Alexeyslav/RGBU_light/MASTER/Schematic/shematic.jpg

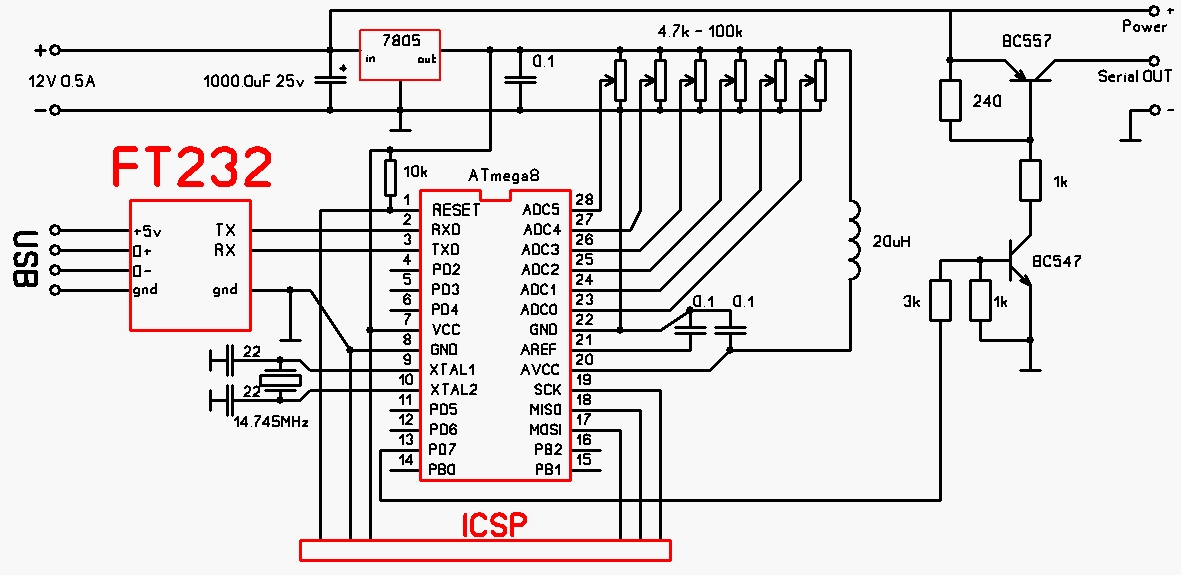
MASTER/Schematic/shematic.jpg
