Alexeyslav/RGBU_light/SLAVE/Calculations/Timing.JPG

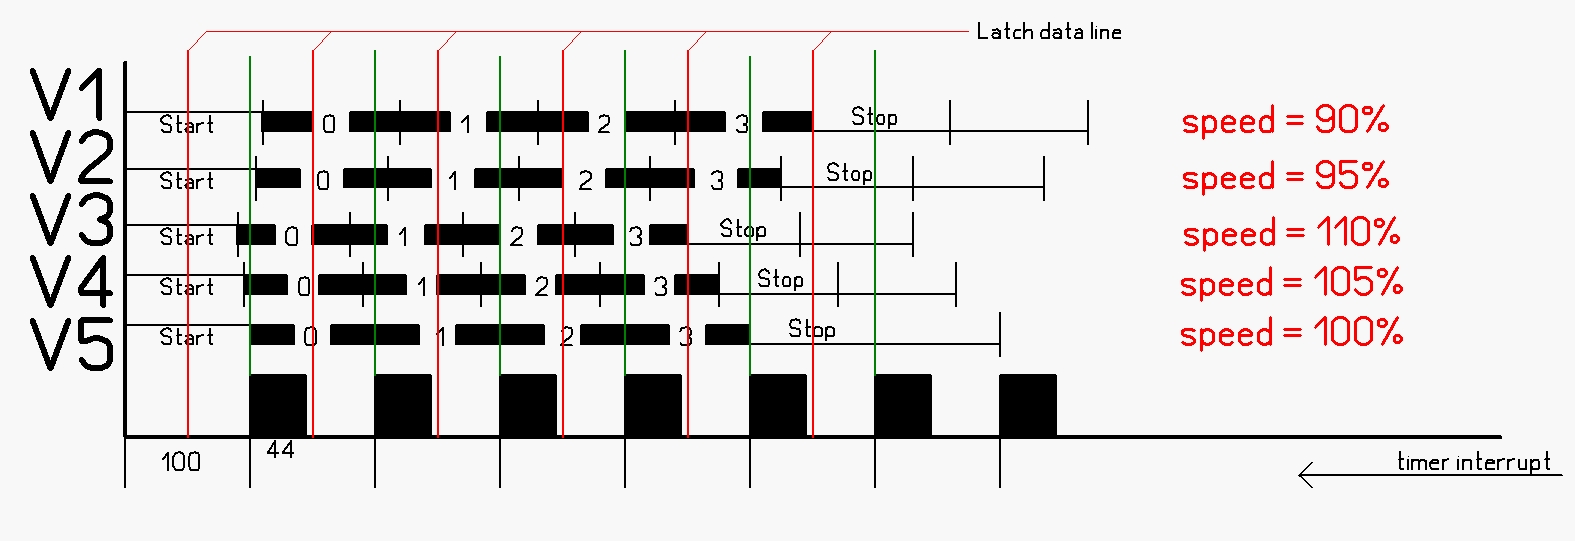
SLAVE/Calculations/Timing.JPG
