Alexeyslav/RGBU_light/SLAVE/Schematic/one_unit_data_pack.jpg

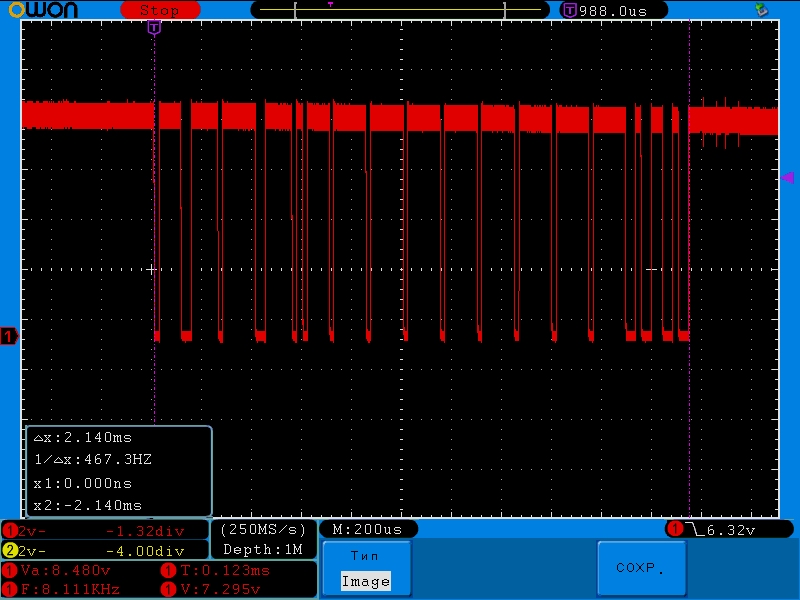
SLAVE/Schematic/one_unit_data_pack.jpg
