Alexeyslav/RGBU_light/SLAVE/Schematic/slave_module_schematic.JPG

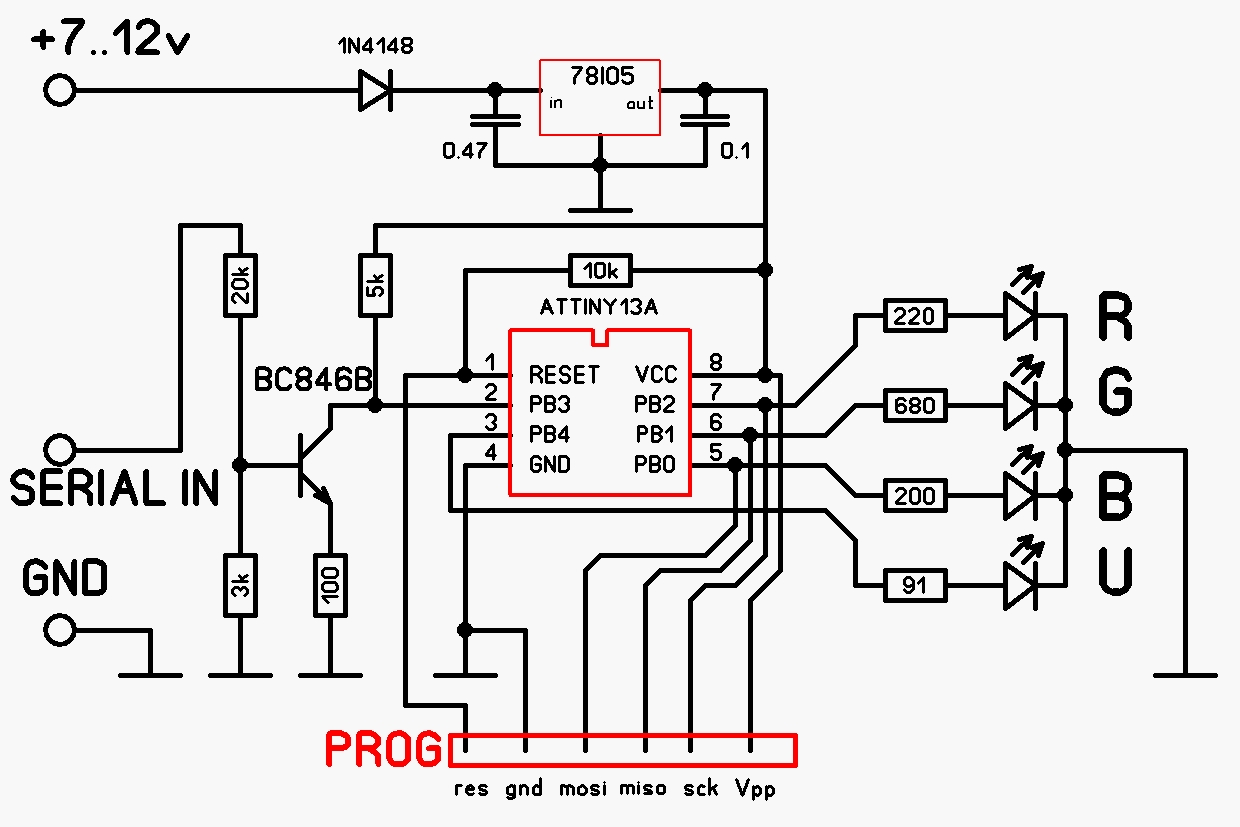
SLAVE/Schematic/slave_module_schematic.JPG
