Alexeyslav/RGBU_light/SLAVE/Schematic/start_osd_rus.jpg

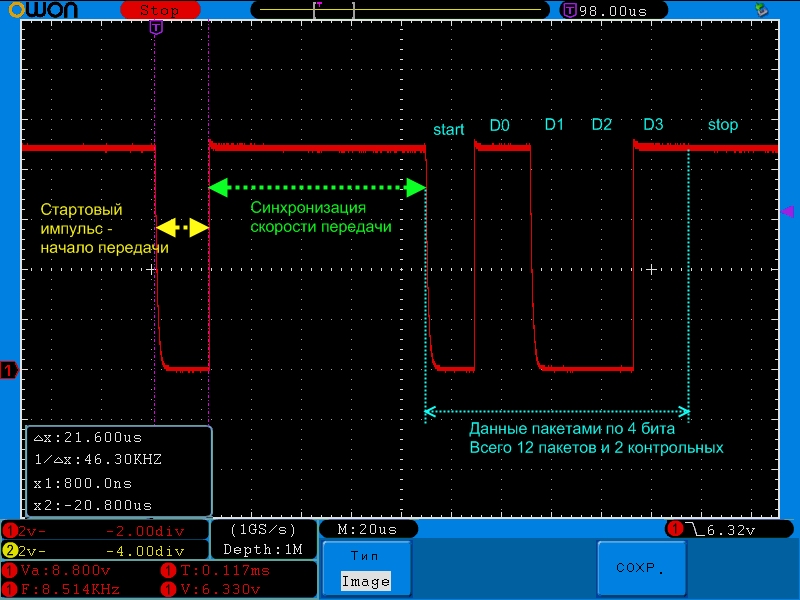
SLAVE/Schematic/start_osd_rus.jpg
