Alexeyslav/RGBU_light/main_shematic.pdf

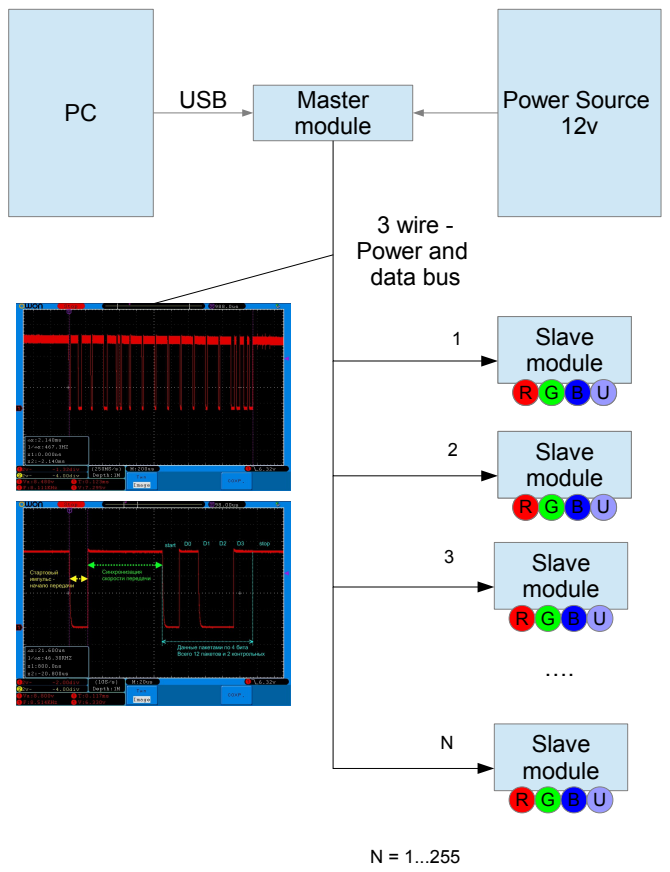
[picture p6: page 1]
Slave module; Master; module; Power Source 12v; USB; 3 wire - Power and data bus; Slave
