Alexeyslav/RGBU_light/MASTER/Calculations/RGBU-MASTER_OUTP.CIR

[Main]
FileType=CIR
Version=7.00
Program=Micro-Cap
Screen=1680,1050
MCAPVersion=7.0.0.0
Key ID=12 345 678
NLCnt=39
TXCnt=1

[shapedef]
Name=Battery
Line=0,0,22,0
Line=22,-3,22,3
Line=26,-7,26,7
Line=26,0,48,0
Current=32,8,16,8

[shapedef]
Name=Pulse_Source
Root="Vsource.root",0,-12,0
Line=20,-4,20,0
Line=20,0,26,0
Line=26,0,26,4

[shapedef]
Name=Resistor
PolyOpen=12 
PolyLine=0,0
PolyLine=0,0
PolyLine=12,0
PolyLine=14,-4
PolyLine=18,4
PolyLine=22,-4
PolyLine=26,4
PolyLine=30,-4
PolyLine=34,4
PolyLine=36,0
PolyLine=48,0
PolyLine=48,0
Current=32,8,16,8

[shapedef]
Name=Capacitor
Line=0,0,22,0
Line=22,-8,22,8
Line=26,-8,26,8
Line=26,0,48,0
Current=32,12,16,12

[shapedef]
Name=NPN
Root="Bjt.root",0,-24,0
PolyClosed=3 ,Solid
PolyLine=20,12
PolyLine=24,12
PolyLine=24,8

[shapedef]
Name=PNP
Root="Bjt.root",0,-24,0
PolyClosed=3 ,Solid
PolyLine=16,-4
PolyLine=20,-4
PolyLine=16,-8
Line=16,-4,14,-2
Line=16,4,14,2

[shapedef]
Name=Ground
Line=0,0,12,0
Line=12,-8,12,8
Line=18,-4,18,4
Line=24,0,24,0

[shapedef]
Name=Vsource.root
Line=0,0,12,0
Line=36,0,48,0
Ellipse=12,-12,36,12
Line=7,5,7,9
Root="Plus.root",39,5,0
Current=32,16,16,16

[shapedef]
Name=Plus.root
Line=-2,0,2,0
Line=0,-2,0,2

[shapedef]
Name=Bjt.root
Line=0,0,13,0
Rectangle=13,-12,15,12,SOLID
Line=24,-24,24,-12
Line=24,-12,14,-2
Line=24,24,24,12
Line=24,12,14,2
Current=32,-24,32,-16
Current=32,24,32,16
Current=0,-8,8,-8

[compdef]
Name=Resistor
Definition=Resistor
Shape=Resistor
Mask=7681
Label Offset=18,6,8,11
PinCnt=2
Pin="Plus",6,0,-10,-4
Pin="Minus",0,0,-14,-4

[compdef]
Name=Ground
Definition=Ground
Shape=Ground
Mask=769
Label Offset=0,0,0,0
PinCnt=1
Pin="PinA",0,0,-3,-7

[compdef]
Name=NPN
Definition=NPN
Shape=NPN
Mask=4097
Label Offset=28,-13,-5,23
PinCnt=3
Pin="Collector",3,-3,4,14
Pin="Base",0,0,-18,-3
Pin="Emitter",3,3,5,1

[compdef]
Name=PNP
Definition=PNP
Shape=PNP
Mask=4097
Label Offset=28,-13,-6,24
PinCnt=3
Pin="Collector",3,3,6,3
Pin="Base",0,0,-19,-3
Pin="Emitter",3,-3,6,15

[compdef]
Name=Pulse Source
Definition=Pulse source
Shape=Pulse_Source
Mask=4865
Label Offset=18,13,15,9
PinCnt=2
Pin="Plus",6,0,-5,-4
Pin="Minus",0,0,-19,-4

[compdef]
Name=Battery
Definition=Battery
Shape=Battery
Mask=5889
Label Offset=19,7,10,13
PinCnt=2
Pin="Plus",6,0,-4,-5
Pin="Minus",0,0,-10,-5

[compdef]
Name=Capacitor
Definition=Capacitor
Shape=Capacitor
Mask=7681
Label Offset=19,8,12,12
PinCnt=2
Pin="Plus",6,0,-3,-5
Pin="Minus",0,0,-14,-5

[Circuit]
WinBackGround Color=15
Grid Text Color=Height=-12,FStyle=0,Color=1,Name=Arial
Object Default=Height=-15,FStyle=0,Color=4,Name=Arial
Component Color=12
Attribute Text=Height=-12,FStyle=0,Color=2,Name=Arial
Wire Color=2
Select Color=9
Pin Connection=Height=-10,FStyle=0,Color=9,Name=Arial
Select Box Color=4
Node Number=Height=-11,FStyle=0,Color=13,Name=Arial
Node Voltage Color=0
Current=Height=-11,FStyle=0,Color=12,Name=Arial
Power/Condition=Height=-11,FStyle=0,Color=9,Name=Arial
Digital Path Color=9
Title Block=Height=-15,FStyle=0,Color=0,Name=Arial
Digital 0 Color=0
Digital R Color=11
Digital F Color=11
Digital 1 Color=9
Digital X Color=7
Digital Z Color=8
Window Placement=2,3, -1,-1, -6,-29, 0,0,1115,553
Window Placement in Analysis=0,1, -1,-1, -6,-26, 837,0,1390,829
Window Placement in Probe=0,0, 0,0, 0,0, 0,0,0,0
Block Select Color=41
TitleBlock Field_1=$name
TitleBlock Field_2=$user $company
TitleBlock Field_3
TitleBlock Field_4=$date
TitleBlock Field_5=Page $page of $maxpage
TitleBlock One Title=True
Title_Block_Border=False
Title_Block=False

[Object]
Object=Rectangle
Grids=91,20,113,61

[Comp]
Name=Resistor
Grid=97,43
Rot=7

[Attr]
ONV=-24,11,PART,R1
Style=8192

[Attr]
ONV=-35,25,VALUE,1200
Style=8192

[Attr]
ONV=-29,56,SLIDER_MAX,500

[Comp]
Name=Ground
Grid=73,56
Rot=7

[Comp]
Name=NPN
Grid=72,47

[Attr]
ONV=28,-13,PART,Q1
Style=8192

[Attr]
ONV=28,2,MODEL,BC547C
Style=8192

[Comp]
Name=Resistor
Grid=58,47

[Attr]
ONV=18,6,PART,R2
Style=8192

[Attr]
ONV=18,21,VALUE,5000
Style=8192

[Attr]
ONV=18,51,SLIDER_MAX,1000

[Comp]
Name=Resistor
Grid=75,35
Rot=1

[Attr]
ONV=8,11,PART,R3
Style=8192

[Attr]
ONV=8,26,VALUE,1000
Style=8192

[Attr]
ONV=8,56,SLIDER_MAX,50

[Comp]
Name=PNP
Grid=75,28
Rot=3

[Attr]
ONV=-10,-39,PART,Q2
Style=8192

[Attr]
ONV=-32,-54,MODEL,BC557C
Style=8192

[Comp]
Name=Pulse Source
Grid=48,53
Rot=3

[Attr]
ONV=-29,-24,PART,V1
Style=8192

[Attr]
ONV=-67,-39,MODEL,IMPULSE

[Comp]
Name=Battery
Grid=35,43
Rot=3

[Attr]
ONV=-24,-28,PART,V2
Style=8192

[Attr]
ONV=-22,-43,VALUE,10v
Style=8192

[Attr]
ONV=-17,-73,SLIDER_MAX,10

[Wire]
Grids=35,25,35,37

[Wire]
Grids=35,25,67,25

[Wire]
Grids=97,25,97,43

[Wire]
Grids=75,28,75,32

[Wire]
Grids=75,41,75,44

[Wire]
Grids=75,50,75,56

[Wire]
Grids=35,56,48,56

[Wire]
Grids=73,56,75,56

[Wire]
Grids=35,43,35,56

[Wire]
Grids=48,53,48,56

[Wire]
Grids=48,56,68,56

[Wire]
Grids=48,47,58,47

[Wire]
Grids=64,47,68,47

[Wire]
Grids=97,49,97,56

[Comp]
Name=Resistor
Grid=67,25
Rot=1

[Attr]
ONV=8,11,PART,R4
Style=8192

[Attr]
ONV=8,26,VALUE,150
Style=8192

[Attr]
ONV=8,56,SLIDER_MAX,150

[Wire]
Grids=67,25,72,25

[Wire]
Grids=67,31,67,32

[Wire]
Grids=67,32,75,32

[Wire]
Grids=75,32,75,35

[Wire]
Grids=103,25,103,40

[Wire]
Grids=97,25,103,25

[Wire]
Grids=103,46,103,56

[Wire]
Grids=97,56,103,56

[Wire]
Grids=75,56,97,56

[Comp]
Name=Capacitor
Grid=103,40
Rot=7

[Attr]
ONV=-28,12,PART,C2
Style=8192

[Attr]
ONV=5,30,VALUE,100E-12
Style=8192

[Wire]
Grids=78,25,97,25

[Comp]
Name=Resistor
Grid=68,50
Rot=7

[Attr]
ONV=-24,11,PART,R5
Style=8192

[Attr]
ONV=-36,26,VALUE,1000
Style=8192

[Attr]
ONV=-36,56,SLIDER_MAX,1000

[Wire]
Grids=68,56,73,56

[Wire]
Grids=68,47,68,50

[Wire]
Grids=68,47,72,47

[Node Offsets]

[Condition Offsets]

[Grid Text]
Text=Load eqvalent
Grid=98,23

[Schematic]
Page 0=0
TabSize 0=320
Page 1=0
TabSize 1=320
Page 2=0
TabSize 2=320
Page 3=0
TabSize 3=320
Splitter.xs=0
Splitter.ys=0
TextQuad=4097
Scale=1
PrinterScale=1
View=305

[Tools]
Pos=Top
SELECT=Yes
COMP=Yes
TEXT=Yes
WIRE=Yes
WIRED=Yes
GRAPHIC=Yes
LINE=No
ELLIPSE=No
RECT=No
DIAM=No
ARC=No
PIE=No
FLAG=Yes
META=No
INFO=Yes
HELP=Yes
DIGTRC=No
DIGTRC2=No
DIGALL=No
GRIDTEXT=Yes
COMPTEXT=Yes
NODE=Yes
NODEV=Yes
CURRENT=Yes
POWER=Yes
CONDITIN=Yes
PIN=Yes
CROSS=Yes
GRID=Yes
BORDER=Yes
TITLE=Yes
RUBBER=Yes
PROPERTY=Yes
STEP=Yes
MIRROR=Yes
ROTATE=Yes
FLIPY=Yes
FILPX=Yes
FINDCOMP=Yes
FIND=Yes
REPEAT=No
MODEL=Yes
CIR2CKT=No
ATTDISP=No
TOFRONT=Yes
TOBACK=Yes
PAGEADD=Yes
PAGEDEL=Yes
ZOOMIN=Yes
ZOOMOUT=Yes
GOTOFLAG=Yes
COLOR=Yes
FONT=Yes

[Page]
Index=0
Name=Page 1
Scale 0=1
Scale 1=1
Scale 2=1
SB 3=110,24
Scale 3=1
Grid=128,23

[Text Area]
Font=Height=-15,FStyle=0,Color=4,Name=Courier New
Comment Color=8
Background Color=15
Len=131
*** From file C:\MC7\LIBRARY\UTILITY.LBR
*** 1ns Impulse Source
.MODEL IMPULSE PUL (P1=0U P2=0.1U P3=20.0U P4=20.1U P5=40.2U)



[Printer]
T.AutoTile=No
T.BlackBorder=No
A.AutoTile=No
A.BlackBorder=No
D.AutoTile=No
D.BlackBorder=No

[TRANSIENT]
AutoTitle=Yes
Grid Weight=1
Grid Pattern=Dot

[AC]
AutoTitle=Yes
Grid Weight=1
Grid Pattern=Dot

[DC]
AutoTitle=Yes
Grid Weight=1
Grid Pattern=Dot

[Analysis]
Window Placement=0,1, -1,-1, -6,-26, 0,0,831,829
Window Placement in Probe=0,0, 0,0, 0,0, 0,0,0,0
Num Out Header Left
Num Out Header Center=$MC\n$user\n$company\n$Analysis of $name\n
Num Out Header Right
Num Out Delimiter=32
Analysis Text=Height=-15,FStyle=0,Color=12,Name=Arial
Analysis Grid Color=8
Analysis Graph Background=15
Object Default=Height=-15,FStyle=0,Color=4,Name=Arial
Analysis Window Background=15
NumOut=Height=-15,FStyle=0,Color=4,Name=Courier New
ScaleColor=On
Select Color=9
Select Box Color=4
Cursor Select Color Primary=7
Cursor Select Color Secondary=9
Tracker Intercept=False
Tracker Mouse=True
Tracker Cursor=True
Tracker Foreground=Height=-15,FStyle=0,Color=0,Name=Arial
Tracker Background=11
Data Point Labels Color Fore=Height=-15,FStyle=0,Color=0,Name=Arial
Data Point Labels Color Back=11
AnimateWait=0
AnimateWaitTime=500
Same Y Scales=Yes
T.Save_For_Future=No
A.Save_For_Future=No
D.Save_For_Future=No
T.Reduce_Display=1
T.Reduce_Save=1
A.Reduce_Display=1
A.Reduce_Save=1
D.Reduce_Display=1
D.Reduce_Save=1

[Tools]
Pos=Top
SELECT=Yes
GRAPHIC=Yes
LINE=No
ELLIPSE=No
RECT=No
DIAM=No
ARC=No
PIE=No
POLYCLOS=No
SCALE=Yes
CURSOR=Yes
MEASUREH=Yes
MEASUREV=Yes
TAG=Yes
TEXT=Yes
PROPERTY=Yes
START=Yes
STOP=Yes
PAUSE=Yes
DATAPTS=Yes
TOKENS=Yes
RULER=Yes
PLUS=Yes
XAXIS=Yes
YAXIS=Yes
MINORLOG=Yes
BASELINE=Yes
HORIZCUR=Yes
GOTOX=Yes
GOTOY=Yes
GOTOPERF=Yes
GOTOBRNC=Yes
NEXT=Yes
NEXTIN=Yes
PEAK=Yes
VALLEY=Yes
HIGH=Yes
LOW=Yes
INFLECTN=Yes
GHIGH=Yes
GLOW=Yes
BOTTOM=Yes
TOP=Yes
AOUTPUT=Yes
ZOOMIN=Yes
ZOOMOUT=Yes
COLOR=Yes
FONT=Yes

[AObject]
Analysis=Transient
Object=MeasureH
Locked=True
EndPoint=ArrowF
w=3
AliasID1=3
w2=0
AliasID2=1
Pos=6.008479999999996e-005,5,6.049962603527687e-005,9.924533512785304
Posm=4.52575878594252
Font=Height=-15,FStyle=0,Color=4,Name=Arial

[Monte Carlo Options]
Analysis=Transient
Status=Off
Distribution=Normal
Number of Runs=10

[Monte Carlo Options]
Analysis=AC
Status=Off
Distribution=Normal
Number of Runs=10

[Monte Carlo Options]
Analysis=DC
Status=Off
Distribution=Normal
Number of Runs=10

[Limits]
Analysis=Transient
TRange=65u, 57u
TStep=0
NPts=51
Temp=70
OPT=120
Horizontal Cursor=False
Temperature Type=Linear

[WaveForm]
Analysis=Transient
Options=LINEARX,LINEARY
AliasID=1
Plt=1
XExp=T
YExp=v(1)
XRng=TMAX,TMIN
YRng=30,-7.5
Range Grid Y=7.5
VFmtX=3
VFmtY=3
SFmtX=3
SFmtY=3
Line Color=12
Text Color=12

[WaveForm]
Analysis=Transient
Options=LINEARX,LINEARY
AliasID=4
Plt=1
XExp=T
YExp=v(6)
XRng=TMAX,TMIN
YRng=30,-7.5
Range Grid Y=7.5
VFmtX=3
VFmtY=3
SFmtX=3
SFmtY=3
Line Color=10
Text Color=10

[WaveForm]
Analysis=Transient
Options=LINEARX,LINEARY
AliasID=2
Plt=2
XExp=T
YExp=v(2)
XRng=TMAX,TMIN
YRng=15
Range Grid Y=3
VFmtX=3
VFmtY=3
SFmtX=3
SFmtY=3
Line Color=9
Text Color=9

[WaveForm]
Analysis=Transient
Options=LINEARX,LINEARY
AliasID=3
Plt=1
XExp=T
YExp=v(4)
XRng=TMAX,TMIN
YRng=30,-7.5
Range Grid Y=7.5
VFmtX=3
VFmtY=3
SFmtX=3
SFmtY=3
Line Color=9
Text Color=9

[Limits]
Analysis=AC
FRange=1E8,1Meg
NPts=51
Temp=27
MaxChng=5
NInput=NONE
NOutput=2
OPT=120
Horizontal Cursor=False
Temperature Type=Linear

[WaveForm]
Analysis=AC
Options=LINEARY
AliasID=1
Plt=1
XExp=F
YExp=db(v(1))
XRng=Auto
YRng=Auto
VFmtX=3
VFmtY=3
SFmtX=3
SFmtY=3
Line Color=12
Text Color=12

[WaveForm]
Analysis=AC
Options=LINEARY
AliasID=2
Plt=2
XExp=F
YExp=ph(v(1))
XRng=Auto
YRng=Auto
VFmtX=3
VFmtY=3
SFmtX=3
SFmtY=3
Line Color=9
Text Color=9

[WaveForm]
Analysis=AC
Options=LINEARY
AliasID=-1
Line Color=2
Text Color=2

[Limits]
Analysis=DC
OPT=0
Horizontal Cursor=False
Temperature Type=Linear
Sweep1 type=Auto
Sweep2 type=None

[WaveForm]
Analysis=DC
Options=LINEARX,LINEARY
AliasID=-1
Plt=1
Line Color=12
Text Color=12

[WaveForm]
Analysis=DC
Options=LINEARX,LINEARY
AliasID=-1
Line Color=9
Text Color=9

[WaveForm]
Analysis=DC
Options=LINEARX,LINEARY
AliasID=-1
Line Color=2
Text Color=2

[Stepping]
Analysis=Transient
Index=1
Method=List
Parameter Type=Component
Name=R1
Param=Value
From=12,25,100,250,500
To=500

[Optimize]
Format=3

[Optimize]
Analysis=Transient
Method=Standard_Powell

[Optimize]
Analysis=AC
Method=Standard_Powell

[Optimize]
Analysis=DC
Method=Standard_Powell

[Watch]
Format=3

[Watch]
Analysis=Transient
ExprPercentWidth=80

[Watch]
Analysis=AC
ExprPercentWidth=80

[Watch]
Analysis=DC
ExprPercentWidth=80

[DSP]
T.Status=Off
A.Status=Off

[TF]
Input Source
Place Text=False

[SENS]
Multiple=False
Parameter Type=Component
