Alexeyslav/RGBU_light/SLAVE/Calculations/RECEIVE_LINE.CIR

[Main]
FileType=CIR
Version=7.00
Program=Micro-Cap
Screen=1680,1050
MCAPVersion=7.0.0.0
Key ID=12 345 678
NLCnt=23
TXCnt=0

[shapedef]
Name=Battery
Line=0,0,22,0
Line=22,-3,22,3
Line=26,-7,26,7
Line=26,0,48,0
Current=32,8,16,8

[shapedef]
Name=Sine_Source
Root="Vsource.root",0,-12,0
Line=24,-6,26,-4
Line=26,-4,26,-2
Line=26,-2,22,2
Line=22,2,22,4
Line=22,4,24,6

[shapedef]
Name=Resistor
PolyOpen=12 
PolyLine=0,0
PolyLine=0,0
PolyLine=12,0
PolyLine=14,-4
PolyLine=18,4
PolyLine=22,-4
PolyLine=26,4
PolyLine=30,-4
PolyLine=34,4
PolyLine=36,0
PolyLine=48,0
PolyLine=48,0
Current=32,8,16,8

[shapedef]
Name=NPN
Root="Bjt.root",0,-24,0
PolyClosed=3 ,Solid
PolyLine=20,12
PolyLine=24,12
PolyLine=24,8

[shapedef]
Name=Ground
Line=0,0,12,0
Line=12,-8,12,8
Line=18,-4,18,4
Line=24,0,24,0

[shapedef]
Name=Vsource.root
Line=0,0,12,0
Line=36,0,48,0
Ellipse=12,-12,36,12
Line=7,5,7,9
Root="Plus.root",39,5,0
Current=32,16,16,16

[shapedef]
Name=Plus.root
Line=-2,0,2,0
Line=0,-2,0,2

[shapedef]
Name=Bjt.root
Line=0,0,13,0
Rectangle=13,-12,15,12,SOLID
Line=24,-24,24,-12
Line=24,-12,14,-2
Line=24,24,24,12
Line=24,12,14,2
Current=32,-24,32,-16
Current=32,24,32,16
Current=0,-8,8,-8

[compdef]
Name=NPN
Definition=NPN
Shape=NPN
Mask=4097
Label Offset=28,-13,-5,23
PinCnt=3
Pin="Collector",3,-3,4,14
Pin="Base",0,0,-18,-3
Pin="Emitter",3,3,5,1

[compdef]
Name=Resistor
Definition=Resistor
Shape=Resistor
Mask=7681
Label Offset=18,6,8,11
PinCnt=2
Pin="Plus",6,0,-10,-4
Pin="Minus",0,0,-14,-4

[compdef]
Name=Ground
Definition=Ground
Shape=Ground
Mask=769
Label Offset=0,0,0,0
PinCnt=1
Pin="PinA",0,0,-3,-7

[compdef]
Name=Battery
Definition=Battery
Shape=Battery
Mask=5889
Label Offset=19,7,10,13
PinCnt=2
Pin="Plus",6,0,-4,-5
Pin="Minus",0,0,-10,-5

[compdef]
Name=Sine Source
Definition=Sine source
Shape=Sine_Source
Mask=4865
Label Offset=18,12,15,12
PinCnt=2
Pin="Plus",6,0,-6,-6
Pin="Minus",0,0,-19,-6

[Circuit]
WinBackGround Color=15
Grid Text Color=Height=-12,FStyle=0,Color=1,Name=Arial
Object Default=Height=-15,FStyle=0,Color=4,Name=Arial
Component Color=12
Attribute Text=Height=-12,FStyle=0,Color=2,Name=Arial
Wire Color=2
Select Color=9
Pin Connection=Height=-10,FStyle=0,Color=9,Name=Arial
Select Box Color=4
Node Number=Height=-11,FStyle=0,Color=13,Name=Arial
Node Voltage Color=0
Current=Height=-11,FStyle=0,Color=12,Name=Arial
Power/Condition=Height=-11,FStyle=0,Color=9,Name=Arial
Digital Path Color=9
Title Block=Height=-15,FStyle=0,Color=0,Name=Arial
Digital 0 Color=0
Digital R Color=11
Digital F Color=11
Digital 1 Color=9
Digital X Color=7
Digital Z Color=8
Window Placement=2,3, -1,-1, -6,-26, 0,0,731,553
Window Placement in Analysis=0,1, -1,-1, -6,-26, 695,0,1179,475
Window Placement in Probe=0,0, 0,0, 0,0, 0,0,0,0
Block Select Color=41
TitleBlock Field_1=$name
TitleBlock Field_2=$user $company
TitleBlock Field_3
TitleBlock Field_4=$date
TitleBlock Field_5=Page $page of $maxpage
TitleBlock One Title=True
Title_Block_Border=False
Title_Block=False

[Comp]
Name=NPN
Grid=65,62

[Attr]
ONV=28,-13,PART,Q1
Style=8192

[Attr]
ONV=-36,-24,MODEL,BC846B
Style=8192

[Comp]
Name=Resistor
Grid=60,62
Rot=6

[Attr]
ONV=-34,6,PART,R1
Style=8192

[Attr]
ONV=-36,-23,VALUE,24k
Style=8192

[Attr]
ONV=-25,36,SLIDER_MAX,100000

[Comp]
Name=Resistor
Grid=68,46
Rot=7

[Attr]
ONV=-24,11,PART,R2
Style=8192

[Attr]
ONV=-22,25,VALUE,5k
Style=8192

[Attr]
ONV=-15,41,SLIDER_MAX,5000

[Comp]
Name=Resistor
Grid=62,67
Rot=7

[Attr]
ONV=-24,11,PART,R3
Style=8192

[Attr]
ONV=-26,28,VALUE,3k
Style=8192

[Attr]
ONV=-15,41,SLIDER_MAX,20000

[Comp]
Name=Ground
Grid=68,75
Rot=7

[Wire]
Grids=62,73,68,73

[Wire]
Grids=68,73,68,75

[Wire]
Grids=62,62,62,67

[Wire]
Grids=62,62,65,62

[Wire]
Grids=60,62,62,62

[Wire]
Grids=68,52,68,59

[Comp]
Name=Battery
Grid=79,66
Rot=3

[Attr]
ONV=-24,-28,PART,V1
Style=8192

[Attr]
ONV=-19,-51,VALUE,5
Style=8192

[Attr]
ONV=-17,-73,SLIDER_MAX,5

[Wire]
Grids=68,46,79,46

[Wire]
Grids=79,46,79,60

[Wire]
Grids=79,66,79,73

[Wire]
Grids=68,73,79,73

[Comp]
Name=Sine Source
Grid=44,70
Rot=3

[Attr]
ONV=-29,-27,PART,V2
Style=8192

[Attr]
ONV=-47,-42,MODEL,1MHZ

[Wire]
Grids=44,62,44,64

[Wire]
Grids=44,62,54,62

[Wire]
Grids=44,70,44,73

[Wire]
Grids=44,73,62,73

[Comp]
Name=Resistor
Grid=68,65
Rot=7

[Attr]
ONV=-24,11,PART,R4
Style=8192

[Attr]
ONV=-29,26,VALUE,100
Style=8192

[Attr]
ONV=-29,56,SLIDER_MAX,500

[Wire]
Grids=68,71,68,73

[Node Offsets]

[Condition Offsets]

[Schematic]
Page 0=0
TabSize 0=320
Page 1=0
TabSize 1=320
Page 2=0
TabSize 2=320
Page 3=0
TabSize 3=320
Splitter.xs=0
Splitter.ys=0
TextQuad=4097
Scale=1
PrinterScale=1
View=305

[Tools]
Pos=Top
SELECT=Yes
COMP=Yes
TEXT=Yes
WIRE=Yes
WIRED=Yes
GRAPHIC=Yes
LINE=No
ELLIPSE=No
RECT=No
DIAM=No
ARC=No
PIE=No
FLAG=Yes
META=No
INFO=Yes
HELP=Yes
DIGTRC=No
DIGTRC2=No
DIGALL=No
GRIDTEXT=Yes
COMPTEXT=Yes
NODE=Yes
NODEV=Yes
CURRENT=Yes
POWER=Yes
CONDITIN=Yes
PIN=Yes
CROSS=Yes
GRID=Yes
BORDER=Yes
TITLE=Yes
RUBBER=Yes
PROPERTY=Yes
STEP=Yes
MIRROR=Yes
ROTATE=Yes
FLIPY=Yes
FILPX=Yes
FINDCOMP=Yes
FIND=Yes
REPEAT=No
MODEL=Yes
CIR2CKT=No
ATTDISP=No
TOFRONT=Yes
TOBACK=Yes
PAGEADD=Yes
PAGEDEL=Yes
ZOOMIN=Yes
ZOOMOUT=Yes
GOTOFLAG=Yes
COLOR=Yes
FONT=Yes

[Page]
Index=0
Name=Page 1
Scale 0=1
Scale 1=1
Scale 2=1
SB 3=263,318
Scale 3=1
Grid=99,52

[Text Area]
Font=Height=-15,FStyle=0,Color=4,Name=Courier New
Comment Color=8
Background Color=15
Len=102
*** From file C:\MC7\LIBRARY\UTILITY.LBR
*** 1MHz Sinusoidal Source
.MODEL 1MHZ SIN (F=100 A=10)



[Printer]
T.AutoTile=No
T.BlackBorder=No
A.AutoTile=No
A.BlackBorder=No
D.AutoTile=No
D.BlackBorder=No

[TRANSIENT]
AutoTitle=Yes
Grid Weight=1
Grid Pattern=Dot

[AC]
AutoTitle=Yes
Grid Weight=1
Grid Pattern=Dot

[DC]
AutoTitle=Yes
Grid Weight=1
Grid Pattern=Dot

[Analysis]
Window Placement=0,1, -1,-1, -6,-26, 0,0,695,829
Window Placement in Probe=0,0, 0,0, 0,0, 0,0,0,0
Num Out Header Left
Num Out Header Center=$MC\n$user\n$company\n$Analysis of $name\n
Num Out Header Right
Num Out Delimiter=32
Analysis Text=Height=-15,FStyle=0,Color=12,Name=Arial
Analysis Grid Color=8
Analysis Graph Background=15
Object Default=Height=-15,FStyle=0,Color=4,Name=Arial
Analysis Window Background=15
NumOut=Height=-15,FStyle=0,Color=4,Name=Courier New
ScaleColor=On
Select Color=9
Select Box Color=4
Cursor Select Color Primary=7
Cursor Select Color Secondary=9
Tracker Intercept=False
Tracker Mouse=True
Tracker Cursor=True
Tracker Foreground=Height=-15,FStyle=0,Color=0,Name=Arial
Tracker Background=11
Data Point Labels Color Fore=Height=-15,FStyle=0,Color=0,Name=Arial
Data Point Labels Color Back=11
AnimateWait=0
AnimateWaitTime=500
Same Y Scales=Yes
T.Save_For_Future=No
A.Save_For_Future=No
D.Save_For_Future=No
T.Reduce_Display=1
T.Reduce_Save=1
A.Reduce_Display=1
A.Reduce_Save=1
D.Reduce_Display=1
D.Reduce_Save=1

[Tools]
Pos=Top
SELECT=Yes
GRAPHIC=Yes
LINE=No
ELLIPSE=No
RECT=No
DIAM=No
ARC=No
PIE=No
POLYCLOS=No
SCALE=Yes
CURSOR=Yes
MEASUREH=Yes
MEASUREV=Yes
TAG=Yes
TEXT=Yes
PROPERTY=Yes
START=Yes
STOP=Yes
PAUSE=Yes
DATAPTS=Yes
TOKENS=Yes
RULER=Yes
PLUS=Yes
XAXIS=Yes
YAXIS=Yes
MINORLOG=Yes
BASELINE=Yes
HORIZCUR=Yes
GOTOX=Yes
GOTOY=Yes
GOTOPERF=Yes
GOTOBRNC=Yes
NEXT=Yes
NEXTIN=Yes
PEAK=Yes
VALLEY=Yes
HIGH=Yes
LOW=Yes
INFLECTN=Yes
GHIGH=Yes
GLOW=Yes
BOTTOM=Yes
TOP=Yes
AOUTPUT=Yes
ZOOMIN=Yes
ZOOMOUT=Yes
COLOR=Yes
FONT=Yes

[Monte Carlo Options]
Analysis=Transient
Status=Off
Distribution=Normal
Number of Runs=10

[Monte Carlo Options]
Analysis=AC
Status=Off
Distribution=Normal
Number of Runs=10

[Monte Carlo Options]
Analysis=DC
Status=Off
Distribution=Normal
Number of Runs=10

[Limits]
Analysis=Transient
TRange=5m
TStep=0
NPts=51
Temp=50
OPT=112
Horizontal Cursor=True
Temperature Type=Linear

[WaveForm]
Analysis=Transient
Options=LINEARX,LINEARY
AliasID=1
Plt=1
XExp=T
YExp=v(1)
XRng=TMAX,TMIN
YRng=10,0
Range Grid Y=2.5
VFmtX=3
VFmtY=3
SFmtX=3
SFmtY=3
Line Color=12
Text Color=12

[WaveForm]
Analysis=Transient
Options=LINEARX,LINEARY
AliasID=2
Plt=1
XExp=T
YExp=v(4)
XRng=TMAX,TMIN
YRng=10,0
Range Grid Y=2.5
VFmtX=3
VFmtY=3
SFmtX=3
SFmtY=3
Line Color=9
Text Color=9

[WaveForm]
Analysis=Transient
Options=LINEARX,LINEARY
AliasID=3
Plt=2
XExp=T
YExp=v(2)
XRng=TMAX,TMIN
YRng=1,0
Range Grid Y=0.5
VFmtX=3
VFmtY=3
SFmtX=3
SFmtY=3
Line Color=2
Text Color=2

[Limits]
Analysis=AC
OPT=0
Horizontal Cursor=False
Temperature Type=Linear

[WaveForm]
Analysis=AC
Options=LINEARY
AliasID=-1
Plt=1
Line Color=12
Text Color=12

[WaveForm]
Analysis=AC
Options=LINEARY
AliasID=-1
Plt=2
Line Color=9
Text Color=9

[WaveForm]
Analysis=AC
Options=LINEARY
AliasID=-1
Line Color=2
Text Color=2

[Limits]
Analysis=DC
OPT=0
Horizontal Cursor=False
Temperature Type=Linear
Sweep1 type=Auto
Sweep2 type=None

[WaveForm]
Analysis=DC
Options=LINEARX,LINEARY
AliasID=-1
Plt=1
Line Color=12
Text Color=12

[WaveForm]
Analysis=DC
Options=LINEARX,LINEARY
AliasID=-1
Line Color=9
Text Color=9

[WaveForm]
Analysis=DC
Options=LINEARX,LINEARY
AliasID=-1
Line Color=2
Text Color=2

[Stepping]
Analysis=Transient
Index=1
Status=On
Parameter Type=Component
Name=Q1
Param=BF
From=200
To=500
Value=100

[Optimize]
Format=3

[Optimize]
Analysis=Transient
Method=Standard_Powell

[Optimize]
Analysis=AC
Method=Standard_Powell

[Optimize]
Analysis=DC
Method=Standard_Powell

[Watch]
Format=3

[Watch]
Analysis=Transient
ExprPercentWidth=80

[Watch]
Analysis=AC
ExprPercentWidth=80

[Watch]
Analysis=DC
ExprPercentWidth=80

[DSP]
T.Status=Off
A.Status=Off

[TF]
Input Source
Place Text=False

[SENS]
Multiple=False
Parameter Type=Component
