Alexeyslav/RGBU_light/(list of files, drawings)

Other design files:
SLAVE/Schematic/slave_module_pcb.lay
SLAVE/Schematic/slave_module_schematic.lay
